GeKoppe/TouchPager/Documentation/TouchPager_Dokumentation_Thilo_Gerrit.pdf

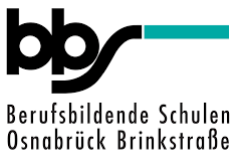
[picture p24: figure]

# Dokumentation Arduino Pager

## Autoren: Thilo Drehlmann, Gerrit Koppe

## Ausbildungsberuf: Fachinformatiker fur Anwendungsentwicklung ¨

## Klasse: IFA12

## Lernfeld 7: Cyberphysische Systeme ergänzen

## 7. Juni 2023

## Inhaltsverzeichnis

1 Ausgangssituation / Formulierung des Themas | 1
2 Ressourcen und Ablaufplanung | 1
3 Durchfuhrung ¨ | 3
4 Projektergebnis | 6
5 Anlagen | 8
5.4 Quellcode Auszuge | ¨ | 22
6 Glossar | 30
7 Quellenverzeichnis | 31

Dokumentation Arduino Pager | Lernfeld 7: Cyberphysische Systeme ergänzen | Thilo Drehlmann, Gerrit Koppe

## 1 Ausgangssituation / Formulierung des Themas

### 1.1 Beschreibung des Projektes

Das Thema des Projektes ist es, eine bidirektionale Kommunikation zwischen zwei Geräten auf Arduino-Basis zu gewährleisten. Es soll die Möglichkeit bestehen, Nachrichten zu verfassen, zu versenden und ebenso Nachrichten zu empfangen, die von einem anderen Arduino Gerät versendet wurden.

### 1.2 Definition der Ziele, erwartetes Ergebnis

1. Es soll möglich sein, mittels eines Touchscreens und einer virtuellen Tastatur, Zeichenketten auf einem, an den Arduino angeschlossenen Touchscreen, zu schreiben.
2. Die eingegebenen Zeichenketten sollen, mittels Funkwellen, an ein anderes Gerät ubertragen werden ¨ können.
3. Das Gerät soll in der Lage sein, Funkwellen zu empfangen.
4. Das Gerät soll außerdem in der Lage sein, die empfangenen Funkwellen wieder zu einer Zeichenkette zu ubersetzen und auf einem Touchscreen anzuzeigen. ¨
5. Es soll ein graphisches User Interface auf dem Touchscreen geben.
6. Es soll möglich sein, empfangene Nachrichten zwischenzuspeichern, damit neu empfangene Nachrichten nicht die vorherigen Nachrichten uberschreiben. ¨
7. Es soll möglich sein, den Zwischenspeicher der Nachrichten uber einen eigenen Men ¨ | upunkt abzurufen ¨
und die empfangenen Nachrichten zu verwalten.
Außerdem gibt es folgende, optionale Ziele:
a. Das User Interface soll anpassbar sein (Farben, Tastaturlayout).
b. Es soll möglich sein, zu uberpr ¨ | ufen, ob empfangsbereite Ger ¨ | äte in der Nähe sind.
c. Es soll möglich sein, die Antenne zu konfigurieren (Distanz und Frequenz).

## 2 Ressourcen und Ablaufplanung

### 2.1 Allgemeine und Ressourcenplanung

Zunächst ist fur die Planung relevant, welche Hardware Komponenten sowohl f ¨ | ur das Versenden von ¨
Nachrichten, als auch fur die menschliche Schnittstelle verwendet werden sollen. ¨
Fur die drahtlose Kommunikation kann auf verschiedene Technologien wie Bluetooth oder Radio-Frequenz ¨
zuruckgegriffen werden. Da Bluetooth nur eine sehr eingeschr ¨ | | | änkte Reichweite besitzt und eine Kopplung
der Geräte notwendig ist, wurde sich dafur entschieden, die drahtlose ¨ | Ubertragung per Radiofrequenz ¨
durchzufuhren. Außerdem existieren f ¨ | ur eine solche ¨ | Ubertragung kosteng ¨ | unstige Hardware und fertige ¨
API-Bibliotheken fur diese. Aus diesen Gr ¨ | unden wurde sich f ¨ | ur die nRF24L01+ Transceiver (im Folgen- ¨

den als ”

Antenne“ oder ”

Transceiver“ bezeichnet) entschieden.¹

Fur die Umsetzung der menschlichen Schnittstelle sollten zun ¨ | | | ächst ein Numpad, sowie ein 16x2 Li-
quid Crystal Display verwendet werden. Aufgrund der stark eingeschränkten Nutzbarkeit des LCD, sowie umständlicher Eingabe uber das Numpad, wurde sich stattdessen entschieden, einen Touchscreen zu ¨ verwenden. Da bereits Arduino Uno R3 Boards der Marke Elegoo zur Verfugung standen, wurde sich ¨ hier fur den Elegoo TFT 2,8” Touchscreen (im Folgenden als ¨
”
| | | TFT“ oder ”

Touchschreen“ bezeichnet)

1Vgl. Hardware Link 1 entschieden.² Dieser hat außerdem den Vorteil, dass Elegoo Bibliotheken mitliefert, um den Touchscreen

zu programmieren.
Schlussendlich musste noch entschieden werden, welches Arduino Board verwendet werden sollte. Aufgrund guter Erfahrung mit der Marke Elegoo in Hinsicht auf Zuverlässigkeit und Nutzbarkeit, wurde sich fur ebenjene Marke entschieden. Da der Touchscreen als Shield ¨

3
fur Arduino Uno Boards konzipiert ¨ ist, wäre es bei einem Arduino Uno nicht mehr möglich, weitere Hardware Komponenten anzuschließen. Entsprechend fiel die Entscheidung auf den Elegoo Arduino Mega R3⁴
, da dieser deutlich mehr Pinouts
zur Verfugung stellt, als ein Arduino Uno. Weitere Gr ¨ | unde f ¨ | ur diese Entscheidung sind, dass der Tran- ¨
sceiver uber den SPI Bus des Arduinos kommuniziert, dieser w ¨ | äre bei einem Arduino Uno aber durch
den TFT blockiert. Außerdem wird viel Quellcode erwartet, was bedeutet, dass der Programmierspeicher

des Arduino Uno zu klein sein könnte, auch hier hat der Arduino Mega mehr Ressourcen.

### 2.2 Ressourcen

### 2.2.1 Benötigte Hardware

In Anhang Tabelle 1 findet sich eine detaillierte, tabellarische Auflistung aller in Kapitel 2.1 genannten Komponenten, ihrer Aufgaben und ihrer Preise. Alle Komponenten werden zwei mal benötigt, da eine Kommunikation zwischen zwei identischen Geräten hergestellt werden soll.

### 2.2.2 Benötigte Software

Zur Umsetzung des Projekts wird, um die Programmierung zu vereinfachen und den Quellcode schlanker zu halten, auf verschiedene externe Bibliotheken zuruckgegriffen. Eine detaillierte Auflistung dieser ¨ Bibliotheken findet sich im Anhang Tabelle 2.

### 2.2.3 Zeitliche Planung der Umsetzung

Ein Netzplan mit detaillierter Zeitplanung findet sich im Kapitel 5.2 Abbildung 2. Der Plan lässt sich weiterhin unterteilen in die Planungsphase (Schritte 1-6) und die Umsetzungsphase (alle weiteren Schritte), abgebildet in Kapitel 5.2 Abbildung 3 und Abbildung 4.

Da vor der Umsetzung des Projekts keine Erfahrung im Umgang mit der Arduino Plattform bestand, wurden bei der Planung der gesamten Planungsphase (Netzplan Schritte 1-6) viel Zeit eingeräumt, durch

die fehlendes Wissen und Einarbeitung kompensiert werden sollten. Des Weiteren wurden 6, beziehungsweise 8 Stunden geplant, damit die Umsetzenden sich mit den einzelnen Komponenten vertraut machen konnten (Netzplan Schritte 4 und 5). Nach erfolgreicher Einarbeitung wurden weitere 2 Stunden fur die ¨ Konzeptionierung des Quellcodes eingeplant⁵
. Die zeitliche Planung der Umsetzung wurde erst nach der
Planungsphase durchgefuhrt, da diese abh ¨ | ängig vom, in der Planung entstandenen, Design des Quellco-
des war.⁶

Aufgrund des entstandenen Quellcode Designs konnte die Entwicklung der einzelnen Klassen parallel ablaufen und nur die Klasse ”

Messenger“ war davon abhängig, dass die anderen Klassen bereits fertig gestellt waren. Entsprechend wurde die Entwicklung der Klassen ”

VKeys“, ”

Radio“ und ”

ColorChooser“
zeitgleich eingeplant, wobei der Radio-Klasse die längste Dauer der Entwicklung eingeplant wurde. Jeder

2Vgl. Hardware Link 3
3Vgl. Glossar 6.2: Shield
4Vgl. Hardware Link 2
5Ergebnis abgebildet in Kapitel 5.2 Abbildung 6.
6Alle bis hier beschriebenen Schritte sind in Kapitel 5.2 Abbildung 3 abgebildet

Klasse wurde außerdem eine Testphase, entsprechend ihrer erwarteten Komplexität, eingeplant.
Im Anschluss wurde die Messenger-Klasse mit dem größten zeitlichen Aufwand von 14 Stunden Entwicklung und 5 Stunden Testen eingeplant, da diese die Kommunikation aller Komponenten sicherstellen soll. Abschließend wurde noch Zeit fur Tests des fertigen Systems und abschließendes Debuggen, sowie das ¨ Schreiben dieser Dokumentation, eingeplant.⁷

### 2.2.4 Erwartete Schwierigkeiten

Im Folgenden werden alle Schwierigkeiten aufgelistet und erklärt, die während der Umsetzung des Pro-

jekts erwartet werden.
1. Distanzregulierung: Die Transceiver können in verschiedenen Signalstärken senden, die programma-
tisch eingestellt werden mussen. Wird eine zu hohe Signalst ¨ | ärke konfiguriert, leidet darunter allerdings
die Ubertragungsqualit ¨ | ät bei niedrigen Distanzen. Hier muss ein gutes Mittelmaß gefunden werden.
2. Wechsel zwischen Empfang und Senden: Da die Nachrichten bidirektional versendet werden sollen, die Transceiver aber nur halbduplex arbeiten, muss ein rechtzeitiger Wechsel der Antenne zwischen Senden und Empfang garantiert werden. Sollten beide Geräte gleichzeitig Senden, werden beide Nachrichten

verloren gehen.
3. Kein Multithreading: Da Arduinos nicht Multithreading-fähig⁸
sind, wird eine Schwierigkeit darin bestehen, permanent gleichzeitig die Nutzung des Geräts und den Empfang eingehender Nachrichten zu gewährleisten.

### 2.2.5 Arbeitsaufteilung

Die genaue Aufteilung der Aufgaben ist dem Netzplan in Abbildung 2 zu entnehmen.
Die Projektschritte wurden allgemein alle gemeinsam unternommen, da die Hardware doppelt aufgebaut werden musste und der Quellcode in einem Git Repository verwaltet wurde, wodurch die Umsetzenden

parallel an den gleichen Klassen arbeiten konnten. Um Zeit zu sparen, wurde nur bei Arbeitsschritten, die parallel ablaufen konnten (z.B. Schritte 7-12) die Arbeit getrennt voneinander durchgefuhrt. ¨

## 3 Durchfuhrung ¨

### 3.1 Schaltplan und Bau des Projekts

Zunächst wurde die Hardware zusammengebaut. Da der Touchscreen als Shield entworfen ist, konnte dieser einfach auf den Arduino Mega gesteckt werden.
Die Transceiver benötigten wiederum eine 5V Stromversorgung, sowie den SPI-Bus⁹ des Arduinos. Der SPI-Bus des Arduino Mega 2560 R3 besteht aus den Pins D50-D53¹⁰, welche nicht durch den

Touchscreen-Shield verwendet werden, weshalb hier keine Probleme entstehen. Fur die 5V Stromversor- ¨

gung wird einer der beiden 5V-Pins in der Pin-Reihe D22-D53 verwendet, da diese noch nicht durch den Touchscreen-Shield verwendet werden.
Somit kann das Projekt ohne Benutzung weiterer Komponenten gebaut werden. Ein Bild des aufgebauten Projekts befindet sich in Kapitel 5.3, Abbildung 14.
Der Schaltplan des Projekts ist in Abbildung 5 dargestellt.

7Alle bis hier beschriebenen Schritte sind in Kapitel 5.2 Abbildung 4 abgebildet

8
vgl. Glossar 6.1: Multithreading
9Vgl. Glossar 6.1: SPI
10Vgl. Abbildung 11

### 3.2 Konzeptionierung der Quellcode-Architektur

Zunächst wurden die Funktionalitäten definiert, die das Projekt bieten muss. Diese wurden anschließend thematisch aufgeteilt und einzelnen Klassen zugeordnet. Die benötigten Funktionalitäten wurden direkt aus den Zielen in Kapitel 1.2 abgeleitet. Die entsprechenden Ziele werden im Folgenden durch Fußnoten referenziert. Ziele können durch mehrere Klassen realisiert werden und können eventuell mehrfach aufgefuhrt werden. ¨
So wurden alle Funktionalitäten, welche mit dem Versenden und Empfangen von Nachrichten zu tun

haben, in einer Klasse gekapselt, welche ”

Radio“ genannt wurde. Diese Klasse sollte sowohl fur das Ver- ¨
senden und Empfangen von, durch den User eingegebenen, Nachrichten, als auch fur die ¨ | Uberpr ¨ | ufung ¨

auf Geräte in der Nähe und die Implementierung der RF24 API verantwortlich sein.¹¹

Eine weitere Aufgabe sollte die Implementierung einer Möglichkeit zur Eingabe von Nachrichten sein. Hier wurde sich dafur entschieden, eine virtuelle Tastatur auf dem Touchscreen anzuzeigen. Die Anzeige ¨ dieser Tastatur, sowie das Erkennen das eingegebenen Buchstaben, sollten in der Klasse ”

VKeys“ gekapselt werden.¹²

Des weiteren sollte eine eigene Klasse zur Auswahl von Farben erstellt werden, welche immer dann in-
stanziiert werden sollte, wenn der User einen Menupunkt ausw ¨ | ählt, mit dem das Aussehen des User
Interface verändert werden kann. Diese Klasse wurde ”

ColorChooser“ bennant und sollte alle möglichen Farben anzeigen und erkennen, welche Farbe ausgewählt wurde.¹³

Letztendlich musste noch eine Klasse konzeptioniert werden, die fur das User Interface verantwortlich ¨ sein sollte. Außerdem wurde sich entschieden, diese Klasse zu verwenden, um alle anderen Klassen zu implementieren und die gesamte Logik zentral zu steuern. Diese Klasse wurde ”

Messenger“ benannt.
Diese Klasse sollte außerdem fur die Men ¨ | uf ¨ uhrung und das Zwischenspeichern von Nachrichten verwen- ¨
det werden.¹⁴

Aus der Konzeptionierung ergab sich dann ein Klassendiagramm, welches in vereinfachter Version in Abbildung 6 dargestellt ist.

### 3.3 Umsetzung des Quellcodes

Da die konzeptionierte Architektur vorsah, eine Hauptklasse zu entwerfen, die wiederum 3 weitere Klassen verwendet, wurde sich entschieden, bei der Entwicklung des Quellcodes den Bottom-Up Ansatz¹⁵ zu

verwenden und zunächst die 3 verwendeten Klassen (”
VKeys“, ”

ColorChooser“ und ”

Radio“) zu entwi-

ckeln. Wie im Netzplan zu erkennen, wurden diese parallel entwickelt. Sowohl bei der Entwicklung von ”
ColorChooser“, als auch bei der von ”

VKeys“ ist aufgefallen, dass Touchscreen und Display, obwohl es die selbe physische Komponente ist, programmatisch zwei verschiedene Koordinatensysteme haben. Somit musste zunächst durch Ausprobieren herausgefunden werden, dass das Display (x,y)-Koordinaten im Bereich ([0,240],[0,320]) und der Touchscreen (x,y)-Koordinaten im Bereich ([120,940],[70,920]) besitzt. Noch dazu ist die Y-Achse der beiden Komponenten zueinander invertiert (Display-Y: 0, Touchscreen-Y: 920 und Display-Y: 320, Touchscreen-Y: 70). Dieser Sachver-

halt ist in Kapitel 5.2, Abbildung 12 graphisch dargestellt. Um diese Diskrepanz zu uberbr ¨ ucken, musste ¨ eine Methode zum Ubersetzen der Koordinaten von Touchscreen zu Display geschrieben werden, um ¨

11Vgl. Kapitel 1.2, Ziele: 2,3,4,b,c
12Vgl. Kapitel 1.2, Ziele: 1,a 13Vgl. Kapitel 1.2, Ziel: a
14Vgl. Kapitel 1.2, Ziele: 2,5,6,7,c 15Vgl. Glossar 6.1: Bottom-Up

Usereingaben trotzdem korrekt zu verarbeiten.¹⁶

Abgesehen von der genannten Schwierigkeit, konnten beide Klassen aber im geplanten Zeitrahmen entwi-

ckelt werden. Im Weiteren wird hier aber hauptsächlich die VKeys Klasse beschrieben, da ”

ColorChooser“
haupsächlich entwickelt wurde, um sich in einer kleinen Klasse mit dem TouchScreen vertraut zu machen. Genutzt wurde bei der Entwicklung von ”

VKeys“ hauptsächlich die von Elegoo mitgelieferte Schnittstelle

zum Display, die in den Bibliotheken ”

TouchScreen“ und ”
Elegoo TFTLCD“ gekapselt wurdeFur beide ¨ Klassen wurde jeweils eine Methode geschrieben, um die TouchScreen-Beruhrung zu interpretieren und, ¨

anhand der eingegebenen Koordinaten, den Wert der gewählten Taste zuruckzugeben ¨

17. Des Weite-

ren wurde fur beide Klassen eine Methode geschrieben, die ihr jeweiliges Interface auf den Bildschirm ¨ druckt.¹⁸
Ebenfalls parallel wurde die Klasse ”
Radio“ entwickelt, die alle Funktionalitäten zur Kommunikation der beiden Geräte beinhalten sollte. Um die Transceiver ansteuern zu können, wurde die RF24 Treiber Bibliothek von TMRh20 verwendet¹⁹. Hier wurden zunächst die Methoden zum Senden²⁰ und zum Empfangen²¹ der Nachrichten entwickelt. Beim Empfangen der Nachrichten musste darauf geachtet werden,

dass diese Methode später auch genutzt werden sollte, um Kommandos zu empfangen, wie zum Beispiel
die Anfrage auf Verfugbarkeit, welche wiederum nicht die empfangene Nachricht zur ¨ | uckgeben sollte, ¨
sondern die Verfugbarkeit zur ¨ | uckmelden. ¨
Eine weitere Schwierigkeit bestand in der Typisierung der zu ubertragenden Nachrichten. Es wurde, der ¨ Ubersichtlichkeit und Einfachheit halber, die meiste Zeit mit dem Datentyp String gearbeitet, um Zei- ¨

chenketten zwischen Methoden zu ubergeben. Da dieser Datentyp aber keine Informationen beinhaltet, ¨ sondern nur einen Pointer zu einem char-Array, kann ein String nicht ubertragen werden. Um dieses ¨ Problem zu umgehen, musste der String vor der Ubertragung zu einem char-Array konvertiert werden ¨

und nach dem Empfangen wieder zuruck zu einem String. Hierf ¨ | ur wurden in der Radio-Klasse Metho- ¨
den geschrieben, die automatisch aufgerufen werden, sobald eine Nachricht versendet oder empfangen wird²²
Um die erwartete Schwierigkeit 2 in Kapitel 2.2.4 präventiv zu unterbinden, wurde sich entschieden, die Klasse so zu bauen, dass beim Verlassen jeder Methode die Antenne wieder auf lauschen gestellt wird und das Senden nur kurzzeitig aktiviert wird, sollte eine Nachricht ubertragen werden. ¨
Schlussendlich wurde fur die ¨
”
Radio“ Klasse noch die Methode geschrieben, um auf verfugbare Ger ¨ | äte
zu uberpr ¨ | ufen. Diese sollte eine vordefinierte Kommandosequenz senden und anschließend abwarten, ob ¨
eine weitere vordefinierte Kommandosequenz zuruckgesendet wird ¨

23
Alle bis zu diesem Punkt entwickelten Klassen wurden einzeln getestet. Zuletzt wurde die Klasse ”

Messenger“ entwickelt, die alle Funktionalitäten des Projekts kapseln und die bisher entwickelten Klassen implementieren sollte²⁴
Zunächst wurden der allgemeine Aufbau des User Interface, sowie die Logik der Menuf ¨ uhrung definiert. ¨ Es wurde entschieden, dass jedes Menu gleich aufgebaut sein soll, um einfachere Verwaltung des Codes ¨ zu gewährleisten²⁵. Damit es immer möglich ist, Nachrichten zu empfangen, musste in jedem Menu der ¨

16Vgl. Kapitel 5.4.1, Codeausschnitt ”
Konvertierung Touchscreen zu Screen Koordinaten“ 17Vgl. Kapitel 5.4.3, Codeausschnitt ”
Erkennung Tastatur Knopf“
18Vgl. Abbildung 18
19Kapitel 7.3, Link 1
20Konzept der Methode in Abbildung 9, Quellcode in Kapitel 5.4.2, Codeausschnitt ” Empfangen von Nachrichten“ 21Konzept der Methode in Abbildung 8, Quellcode in Kapitel 5.4.2, Codeausschnitt ” Senden von Nachrichten“
22Vgl. Kapitel 5.4.2, Codeausschnitt ”
Konvertierung String zu Char-Array“ 23Vgl. Abbildung 10, Quellcode in Kapitel 5.4.2, Codeausschnitt ”
Uberpr ¨ | ufung auf verf ¨ | ugbare Ger ¨ | äte“
24Vgl. Abbildung 6
25Vgl. Abbildung 7, Beispielcode eines Menus in Kapitel 5.4.1, Codeausschnitt ¨ ”
Beispiel Menuf ¨ uhrung: Optionenmen ¨ | u“¨

Klasse regelmäßig auf eingehende Nachrichten uberpr ¨ uft werden und, sollte eine Nachricht empfangen ¨ werden, diese Nachricht, entsprechend des Ziels 6 aus Kapitel 1.2, in einen Nachrichtenspeicher geschrieben werden. Da der Arduino nicht Multithreadfähig ist²⁶, konnte der Prozess nicht parallel laufen,

weswegen die Funktion in jedem einzelnen Menu eingebaut werden musste. ¨
Es wurde ein Hauptmenu entwickelt, aus dem heraus ausgew ¨ | ählt werden kann, ob eine Nachricht geschrie-
ben, empfangene Nachrichten im Zwischenspeicher gelesen, das Gerät konfiguriert oder auf Verfugbarkeit ¨ anderer Geräte getestet werden soll²⁷. Wird ”
Schreiben“ ausgewählt, wird eine Methode aufgerufen, die

”

VKeys“ Klasse initialisiert, wodurch es ermöglicht wird, eine Nachricht zu verfassen. Unter ”

Optionen“
wurden alle Möglichkeiten der Konfiguration, wie zum Beispiel Anpassung der Farben des Interface durch Instanziierung der ”

ColorChooser“-Klasse, aber auch die Konfiguration der Distanz durch Einstellen des

”

Radio“-Objekts. Des Weiteren wurde ein Menupunkt eingef ¨ | ugt, mit welchem manuell auf verf ¨ | ugbare ¨
Geräte in der Nähe gepruft werden kann, welcher wiederum bei Auswahl die entsprechende Methode des ¨

”

Radio“-Objekts aufruft²⁸
Der Zwischenspeicher wurde uber einen privaten String-Array realisiert, in den jede empfangene Nach- ¨ richt geschrieben wird. Hier wurde sich entschieden, dem Speicher nur eine Größe von 3 Nachrichten zu geben, um den Speicherplatz des Arduinos zu schonen. Wird eine Nachricht empfangen und der
Array ist bereits gefullt, so wird die ¨ | älteste Nachricht gelöscht, um Platz fur die neue Nachricht zu ma- ¨
chen²⁹. Dieser Zwischenspeicher kann im Hauptmenu unter ¨
”

Lesen“ ausgelesen werden und es besteht die Möglichkeit, alte Nachrichten manuell zu löschen.
Nachdem die ”

Messenger“-Klasse entwickelt war und alle weiteren Klassen in diese implementiert wurden, wurde das gesamte Projekt noch abschließend getestet und jeglicher Fehler behoben, der bei der Implementierung aufgetreten war.

## 4 Projektergebnis

### 4.1 Qualitätskontrolle

Ein wichtiges Qualitätsmerkmal des Projekts ist die korrekte und zuverlässige Ubertragung eingegebener ¨

Nachrichten. Um dies zu testen, wurden mit jeder der konfigurierbaren Einstellungen der Signalstärke der RF24-API (Min, Low, High und Max) 5 mal die gleiche Nachricht in verschiedenen Distanzen gesen-

det und gezählt, wie viele der Nachrichten korrekt ubertragen wurden ¨

30. Hier muss allerdings erwähnt
werden, dass die Ubertragung in einem Geb ¨ | äude mit groß ausgebautem WLAN Netz getestet wurde,

dementsprechend also sowohl Wände, als auch WLAN-Interferenzen das Testergebnis beeinträchtigt haben könnten. Des Weiteren waren die Stichprobe und die Dsitanzen relativ klein.
Es ist aber zu erkennen, dass jede der Signalstärkeneinstellungen in mindestens einer der getesteten
Distanzen jede Nachricht korrekt ubertragen hat, die Qualit ¨ | ät der Ubertragung also gut ist. ¨

Leider werden, da die Transceiver innerhalb des 2.4GHz Bands arbeiten, auch teilweise Interferenzen als Nachrichten erkannt, was durch die Umsetzung nicht abgefangen wurde.
Des Weiteren sind die Arduinos aktuell noch auf ein Netzteil angewiesen, da ansonsten die Ubertragung ¨

fehlschlägt, da die 5V Pins des Arduino Mega die Transceiver nicht korrekt zu versorgen scheinen, was durch die Umsetzenden nicht behoben werden konnte. Auch eine angeschlossene Batterie hat leider keine

26Vgl. Kapitel 2.2.4, Punkt 3
27Vgl. Abbildung 15
28Vgl. Abbildung 10, Quellcode in Kapitel 5.4.2, Codeausschnitt ”
Uberpr ¨ | ufung auf verf ¨ | ugbare Ger ¨ | äte“
29Vgl. Kapitel 5.4.1, Codeausschnitt ”
Nachrichten zwischenspeichern“ 30Vgl. Abbildung 13

Abhilfe geschaffen. Sind die Netzteile nicht angeschlossen, ist die Ubertragung gar nicht m ¨ | öglich oder

der Transceiver gibt unregelmäßig Signale an den Arduino weiter, welche wiederum als unleserliche Zei-

chenketten interpretiert werden. Dieses Verhalten wird auch durch einen Wackelkontakt des Kabels am 5V Pinout ausgelöst, was wiederum durch Löten der Komponenten behoben werden könnte, allerdings nicht umgesetzt ist.

### 4.2 Soll-Ist-Vergleich

Im Folgenden wird uberpr ¨ uft, ob die in Kapitel 1.2 erreicht wurden. ¨ Ziel 1 wird durch die Klasse ”

VKeys“ abgebildet und in der Klasse “Messenger”

implementiert. Es ist
auch möglich, Sonderzeichen zu schreiben, das Ziel ist also erfullt ¨

31
Die Ziele 2, 3 und 4 werden durch die Klasse ”

Radio“ abgebildet und ebenfalls durch die Klasse ” Messen-
ger“ implementiert. Die Qualität der Ubertragung wurde getestet und das Ergebnis ist zufriedenstellend ¨ | 32
Dieses Ziel ist somit ebenfalls erreicht.
Ziel 5 wird durch die Klasse ”

Messenger“ abgebildet und implementiert. Das graphische User-Interface hat außerdem eine Menuf ¨ uhrung ¨

33. Entsprechend kann das Ziel als erreicht bewertet werden.

Ziel 6 wird ebenfalls durch die Klasse ”
Messenger“ abgebildet und implementiert. Es existiert ein Zwi-
schenspeicher fur insgesamt 3 Nachrichten, aus dem die ¨ | älteste Nachricht entfernt wird, sollte eine
weitere Nachricht empfangen werden. Dieses Ziel ist somit abgebildet
Ziel 7 wird auch durch die Klasse ”

Messenger“ abgebildet und implementiert. Es wurde im Hauptmenü
ein eigener Menupunkt zum Lesen der Nachrichten implementiert, der wiederum in ein eigenes Men ¨ | ü
fuhrt ¨

34, das Ziel ist also erfullt. ¨
Auch die optionalen Ziele wurden alle erfullt. Es ist m ¨ | öglich, das User Interface farblich anzupassen³⁵
,
es ist möglich, manuell zu prufen, ob empfangsbereite Ger ¨ | äte in der Nähe sind und es kann uber die ¨
Optionen die Sendedistanz eingestellt werden.
Zusammenfassend kann also gesagt werden, dass jedes Ziel erfullt wurde, die Ger ¨ | äte allerdings nicht mo-
bil sind, da noch keine Lösung fur das ben ¨ | ötigte Netzteil gefunden wurde, wodurch eine der Grundideen
des Projekts leider nicht realisiert wurde.

### 4.3 Ausblick

Es wurde noch keine Halterung / kein Case fur das Projekt gebaut, wodurch es aktuell noch nicht robust ¨

ist. Sollte das Projekt fortgesetzt werden, wäre dies der nächste Schritt.
Eine interessante Erweiterung fur das Projekt w ¨ | äre außerdem die Entwicklung eines eigenen Formats der
Nachrichten oder einem eigenen Protokoll der Ubertragung, um sicherzustellen, dass nur Nachrichten, die ¨

tatsächlich von Geräten mit der entwickelten Technologie, verarbeitet werden und somit Interferenzen ignoriert werden. So könnten außerdem, zu den Nachrichten gehörende, Metadaten (Uhrzeit, Geräte-
ID etc.) ubertragen werden, wodurch die Kommunikation deutlich pr ¨ | äziser wird und auch nur, sollten
mehrere Geräte gleichen Typs in der Umgebung verfugbar sein, ein bestimmtes Ger ¨ | ät angesprochen
werden. Ein solches Protokoll wurde auch das Senden von Kommandosequenzen vereinfachen. ¨

31Vgl. Abbildungen 18 und 19 32Vgl. Abbildung 13
33Vgl. Abbildung 15
34Vgl. Abbildung 20
35Vgl. Abbildung 17 und Abbildung 16

## 5 Anlagen

### 5.1 Auflistung der Komponenten

Tabelle 1: Benötigte Hardware

Hardware | Aufgabe | Kosten
Arduino Mega 2560 | - Zentrale Schnittstelle aller Komponenten - Programmierbarkeit, Verwaltung der Logik | 2 x 21,99¿
Elegoo Uno TFT Touchscreen 2,8” | - Anzeige von Nachrichten - Eingabe von Nachrichten - User Interface | 2 x 19,99¿
nRF24L01+ Wireless Transcei-ver Modul | - Nachrichten Ubertragen und Empfangen ¨ - Uberpr ¨ ufung Verf ¨ ugbarkeit anderer Ger ¨ äte | 2 x 5,-¿
Elegoo Power Supply 9V | - Stromzufuhr fur 5V Pin ¨ | 2 x 8,99¿

Gesamtkosten: 111.92¿.
Links zur genutzten Hardware sind in Kapitel 7.2 aufgefuhrt. ¨

Tabelle 2: Benötigte Software

Bibliothek | Aufgabe | Quelle
Elegoo GFX.h | Kern Grafikbibliothek des Elegoo Uno TFT Touchs-creens. Ermöglicht das Drucken von Zeichen / For-men auf TFT Display. | Mitgeliefert auf CD bei TFT Touchs-creen
Elegoo TFTLCD.h | Hardware-Bibliothek des Elegoo Uno TFT Touchs-creens. Verantwortlich fur die Kommunikation des ¨ Programms mit der Hardware. | Mitgeliefert auf CD bei TFT Touchs-creen
TouchScreen.h | Bibliothek des Touchscreens des Elegoo Uno TFT Touchscreens. Erlaubt das erkennen von Beruhrungen des Touchscreens und die Lokalisierung ¨ der Beruhrung. ¨ | Mitgeliefert auf CD bei TFT Touchs-creen
SPI.h | Erlaubt die Kommunikation des Programms mit dem SPI Bus des Arduino Board | In Arduino IDE in-kludiert
nRF24L01.h | Hardware Bibliothek der nRF24L01+ Transceiver. Erlaubt Kommunikation des Moduls mit dem Ardui-no Board | Github
RF24.h | Programmierbare Schnittstelle der nRF24L01+ Transceiver. | Github
Arduino.h | Liefert Kernfunktionen der Arduino Boards. | In Arduino IDE in-kludiert

Links zur genutzten Software sind in Kapitel 7.3 aufgefuhrt. ¨

### 5.2 Diagramme


Abbildung 1: Legende der Netzplan Knoten


Abbildung 2: Netzplan des Projekts

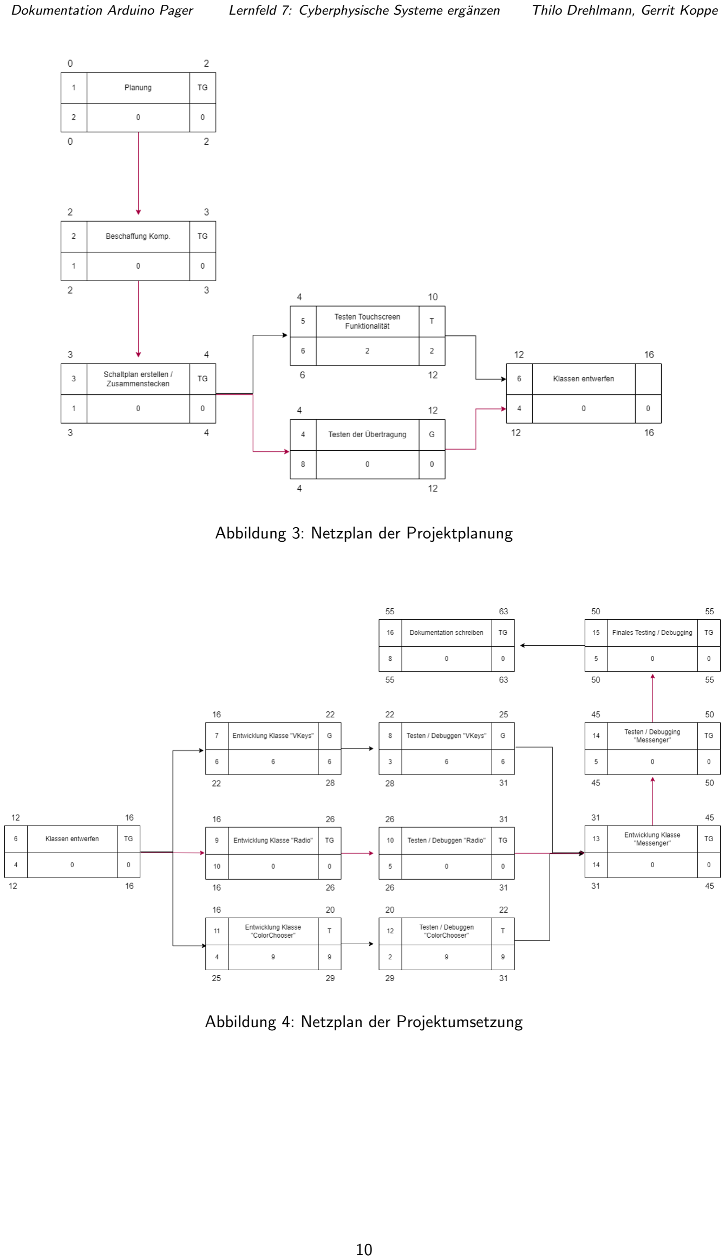
[picture p25: page 12]

Abbildung 3: Netzplan der Projektplanung

Abbildung 4: Netzplan der Projektumsetzung

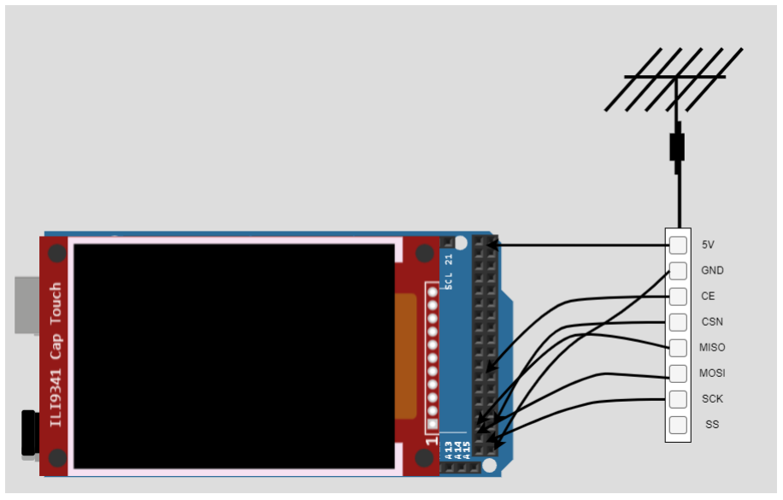
[picture p26: figure]

Abbildung 5: Schaltplan des Projekts

Da kein Tool gefunden wurde, das die im Projekt verwendeten Komponenten bereitstellt, wurde hier auf einen händisch erstellten Schaltplan zuruckgegriffen. Der Touchscreen wird als Shield verwendet und in den Arduino ¨ Mega gesteckt. Die Pin-Aufteilung der Transceiver lautet wie folgt:

Transceiver | Arduino
V++ | 5V
GND | GND
MISO | D50
MOSI | D51
SCK | D52
CE | D43
CSN | D53


Abbildung 6: Vereinfachtes Klassendiagramm des Arduino Programms


Abbildung 7: Aufbau der Menumethoden ¨


Abbildung 8: Ablauf des Nachrichtenempfangs


Abbildung 9: Ablauf des Sendens von Nachrichten


Abbildung 10: Ablauf des Testens auf verfugbare Ger ¨ | äte


Abbildung 11: Pinout Beschreibung des Arduino Mega 2560 R3, Quelle: Internetquelle 4

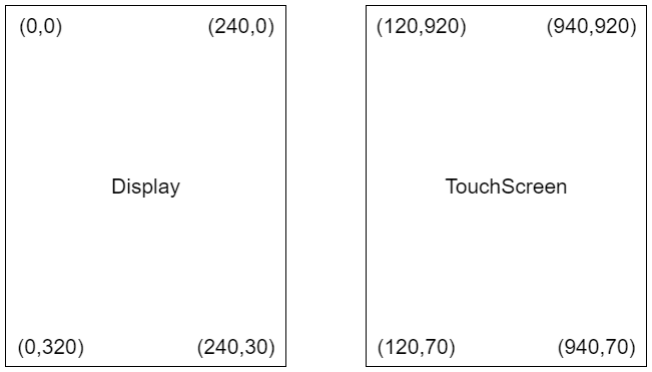
[picture p27: figure]

Abbildung 12: Darstellung der Koordinaten von Touchscreen und Display (x,y)

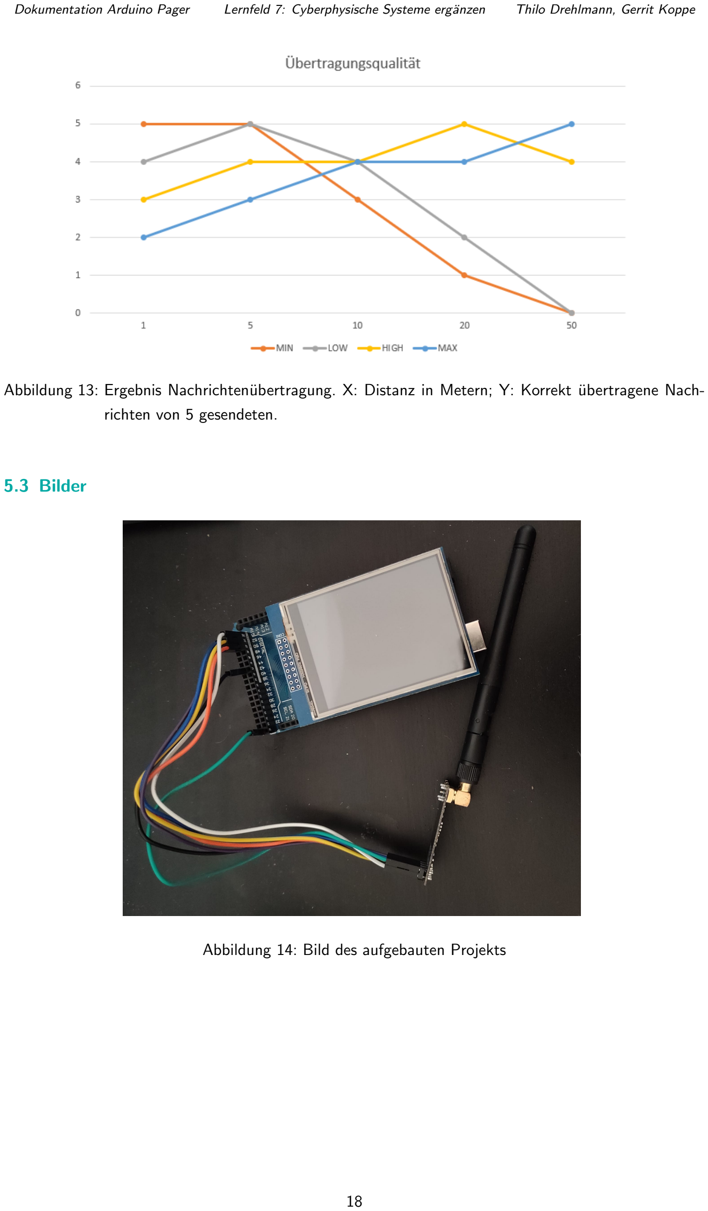
[picture p28: page 20]

Abbildung 13: Ergebnis Nachrichtenubertragung. X: Distanz in Metern; Y: Korrekt ¨ | ubertragene Nach- ¨
richten von 5 gesendeten.

### 5.3 Bilder

Abbildung 14: Bild des aufgebauten Projekts


Abbildung 15: Standard-Hauptmenu des Projekts ¨


Abbildung 16: Hauptmenu des Projekts mit Lightmode ¨


Abbildung 17: Farblich angepasstes Hauptmenü


Abbildung 18: Virtuelle Tastatur des Projekts


Abbildung 19: Virtuelle Tastatur des Projekts mit Sonderzeichen


Abbildung 20: Menu zum Lesen eingegangener Nachrichten ¨

### 5.4 Quellcode Auszuge ¨

Der gesamte Quellcode ist in einer Zip-Datei beigefugt. ¨
Im Folgenden sind in der Dokumentation benannte Funktionen und Methoden angefugt. ¨

### 5.4.1 Klasse: Messenger

Konvertierung Touchscreen zu Screen Koordinaten

/**

* @brief
* Parses Coordinates from touchpoint to screen coordinates *
* @param p TSPoint, Point the user touched on display
* @return ScreenParse Struct containing parsed screen coordinates */
ScreenParse Messenger::parseCoords(TSPoint p) {

ScreenParse parse;

// Touch X: [120,940], Screen X: [0,240] // Parse X
parse.x = (int) ((p.x - 120) / 3.5);

// Touch Y: [70,920], Screen Y: [0,320] // Parse Y
parse.y = (int) ((p.y - 70) / 2.66);

return parse;
}
Beispiel Menuf ¨ uhrung: Optionenmen ¨ | ü

/**

* @brief
* Options menu
*
*/
void Messenger::optsMenu(void) { pinMode(A2, OUTPUT);
pinMode(A3, OUTPUT);

Menu menu;
menu.menuStart = 60;
menu.menuThickness = 40;
menu.menuOffset = 20;
menu.header = "Optionen";
menu.entries[0] = String("Farben"); menu.entries[1] = String("Tastatur"); menu.entries[2] = String("Distanz"); menu.entries[3] = String("Zurueck"); menu.entries[4] = String("\0");

drawMenu(menu);

delay(100);

while (true) {
String inc = receiveMessage();
if (inc != "\0") Serial.println(inc);

int selection = -1;

// Get touchpoint
digitalWrite(13, HIGH);
TSPoint p = _ts->getPoint(); digitalWrite(13, LOW);

// If touch was recognized if (p.z > _minTouch) {
// Get selected menu poin
selection = getSelection(menu.menuStart, menu.menuThickness, menu.menuOffset, 4, parseCoords(p));

Serial.println("Selection: " + String(selection));

switch (selection) {

case -1: break;
case 1: colorMenu(); return; case 2: keysMenu(); return; case 3: distanceMenu(); return;

case 4: return;
default: break;
}
}
delay(10);
}

Serial.println("Returning from optsMenu"); }

Nachrichten zwischenspeichern

/**

* @brief
* Caches incoming messages in message cache *
* @param msg String to be cached
*/
void Messenger::cacheMessage(String msg) { // Check, how many messages are in cache

int counter = 0;
for (int i = 0; i < 3; i++) {
if (_messages[i] != "\0") {

counter++;
continue;

} else {

break;
}
}

// If message already is in cache, return for (int i = 0; i < counter; i++) {
if (msg == _messages[i]) return;
}

// If there are less than 3 messages, just cache the newest message on last position if (counter < 3) {
_messages[counter] = msg;

return;
} else {
// If there are 3 messages, clear the last message _messages[0] = "\0";

// Push every other message one to the back for (int i = 1; i < 3; i++) {
_messages[i - 1] = _messages[i];
}

// Put new Message as first in the array _messages[2] = msg;

return;
}
}

### 5.4.2 Klasse: Radio

Empfangen von Nachrichten

/**

* @brief
* Receives message from radio frequency
*
* @return String received message or \0, if nothing was gotten */
String Radio::receiveMessage(void) {
char buffer[128] = "";

String msg = "";

// Switch from sending to listening if (!_listening) switchState();

// If no message is available, return universal break character if (!_antenna.available()) {
//Serial.println("Receiving: No Antenna available"); return "\0";

}
Serial.println("Receiving: Antenna available");

// Read available payload
_antenna.read(&buffer, sizeof(buffer));

for (int i = 0; i < 128; i++) {
msg += String(buffer[i]);
if (buffer[i] == ’\0’) break; }

Serial.println("Receiving: Received char Array: " + msg);

// If the test string was received, acknowledge it and return \0 if (msg == String(_test)) {
Serial.println("Receiving: Test string, now acknowledging."); acknowledge();
return "\0";
}

// If acknowledge string was received, change marker in class fields to true so it can be checked by other methods and return \0
if (msg == String(_acknowledge)) {
Serial.println("Receiving: Acknowledge String");

_ackHappened = true;
return "\0";
}

return msg;
}

Senden von Nachrichten

/**

* @brief
* Sends message given in param *
* @param msg Message to be sent
* @return true If sending was successful * @return false otherwise
*/
bool Radio::sendMessage(String msg) {

String sendTest = "";
bool tx_ok, tx_fail, rx_ready, test = true; char buffer[128];
msg.toCharArray(buffer, msg.length() + 1);

Serial.println("Sending message: " + msg);
Serial.println("Listening State: " + String((_listening ? "listening" : "writing")));

if (_listening) switchState();

Serial.println("Listening State: " + String((_listening ? "listening" : "writing")));

// convertStringToCharArray(msg, buffer);
for (int i = 0; i < msg.length(); i++) { sendTest += String(buffer[i]);
}
Serial.println("Sending: Char Arr after conversion: " + sendTest);

test = _antenna.write(&buffer, sizeof(buffer));

if (!test) {
Serial.println("Sending unseccessful");
_antenna.whatHappened(tx_ok, tx_fail, rx_ready);
Serial.println("OK: " + String((tx_ok ? "Yes" : "No")) + ", FAIL: " + String((tx_fail ? "Yes" : "No")) + ", READY: " + String((rx_ready ? "Yes" : "No")));
switchState();

return false;
}

Serial.println("Returning from sending"); switchState();

return true;
}
Uberpr ¨ | ufung auf verf ¨ | ugbare Ger ¨ | äte

/**

* @brief
* Checks, whether there are devices available nearby *
* @return true If there are devices available nearby * @return false otherwise
*/
bool Radio::checkNearbyDevices(void) {

_ackHappened = false;
bool msg[5] = {false, false, false, false, false};

for (int i = 0; i < 5; i++) {
sendMessage(_test);
receiveMessage();

msg[i] = wasAcknowledged();
Serial.println("Msg " + String(i) + ": " + String((msg[i] ? "True" : "False"))); delay(1000);
}

// If payload was the acknowlege String, that means there are devices nearby.

for (int i = 0; i < 5; i++) { if (msg[i]) return true;
}

Serial.println("_ack: " + String((_ackHappened ? "True" : "False")));

_ackHappened = false;
return false;
}

Konvertierung String zu Char-Array

/**

* @brief
* Converts a given String s to a char array and saves it to given pointer a *
* @param s Strung to be converted to char array
* @param a Pointer to char array
*/
void Radio::convertStringToCharArray(String s, char a[128]) {

int counter = 0;

// Iterate through entire String and add character to char array for (int i = 0; i < s.length(); i++) {
a[i] = s.charAt(i);

counter++;
}

// Fill up char array with empty values for (int i = counter; i < 128; i++) { a[i] = ’\0’;
}

Serial.println("Char Arr after conversion: " + String(a)); }

Wechsel zwischen senden und lauschen

/**

* @brief
* Switches from listening to sending and the other way around *
*/
void Radio::switchState() { byte _adress[6] = "00001"; // Invert listening

_listening = !_listening;

// If listening: Prepare antenna for listening. Otherwise: Prepare antenna for sending

if (_listening) {
_antenna.openReadingPipe(_readingPipe, _adress); _antenna.startListening();
} else {
_antenna.stopListening();
_antenna.openWritingPipe(_adress); }

_antenna.setPALevel(_level); }

### 5.4.3 Klasse: VKeys

Erkennung Tastatur Knopf

/**

* @brief
* Returns selected char by calculating, which column and row was pressed from passed x and y coords
*
* @param x X coordinate from touchscreen selection
* @param y Y coordinate from touchscreen selection
* @return String Selected character parsed to a string, BACK if back button was selected and DONE, if done button was selected
*/
String VKeys::getCharFromCoords(int16_t x, int16_t y) {

int row, column;

// Complete Y: [70,920], range 850, keyboard [70,475], keyboard range of 405, 4 rows so 405/4 = 101.25
if (y > 475) return String(’\0’);
row = (int) ((y - 70)/ 101.25);

// row 0 is spacebar, therefore return escaped space immediately, as nothing else is

there.
if (row == 0) {
int tempX = (int)((x - 120) / 3.5);

if (tempX < (_screen->width() / 4)) {
return String("BACK");
} else if (tempX > 3*(_screen->width() / 4)) { return String("DONE");
}
return String(" ");
}

if (row > 3) return String(’2’);

// X Range ca. 120 - 920 for 10 columns, therefore 800 / 10 = 80 column = (int) ((x - 120)/ 80);

if (column < 11 && column >= 0 && row < 4 && row >0) return String(_special ? _specialChars[(3-row)][column] : _rows[(3-row)][column]);

return String(’-’);
}

### 5.4.4 Klasse: ColorChooser

Erkennen der ausgewählten Farbe

/**

* @brief
* Analyses coordinates passed into function and returns selected color *
* @param coords Coordinates of touchpoint, parsed to screen coordinates
* @return uint16_t chosen Color or 0, if cancelled or -2, if selection was not valid */
uint16_t ColorChooser::getSelection(Coords coords) {

int column, row;

Serial.println("CC: X: " + String(coords.x) + ", Y: " + String(coords.y));

// Check, if touchpoint is at height of cancel button
if (320 - coords.y > 250) return 0;

// If coordinates are out of valid ranges, return failure marker if (coords.x < 35 || coords.x > 215) return -2;
if (coords.x < 135 && coords.x > 100) return -2;

// If x is less than 100, it has to be first column (index 0), otherwise second column (index 1)

column = coords.x < 100 ? 0 : 1;

// Invert coordinates (320-y, because screen is 320 high) and divide by 60, because

that’s the
// height of the boxes, to get the row
row = (int)((320 - coords.y) / 60);

// Variable basically only exists, so that we don’t try to reach indices the array

does not have
// This works, because the first column has indices 0,2,4,6 and second has 1,3,5,7 int safeHandler = column + (row*2);

// If selection > 7, set selection to failure, otherwise set selection to selected

color
uint16_t selection = (safeHandler > 7 ? -2 : _colors[safeHandler]);

return selection;
}

## 6 Glossar

### 6.1 Technische Begriffe

Multithreading
Unter Multithreading versteht man in der Informatik den Prozess, ein Programm in mehrere Teilstränge aufzuteilen, die parallel ausgefuhrt werden. ¨

36

SPI-Bus
SPI steht fur Serial Peripheral Interface und ist ein, aus drei Leitungen bestehendes, Bussystem nach dem ¨ Master-Slave Prinzip, mit dem die Kommunikation verschiedener Komponenten gesteuert werden kann.³⁷

Bottom-Up
Der Bottom-Up Ansatz beschreibt in der Software-Entwicklung die Vorgehensweise, zunächst Teilfunktionen oder einzelne Klassen zu entwickeln und diese, nach ihrer Fertigstellung, zu einem System zu-
sammenzufuhren. Im Gegensatz hierzu wird bei der Top-Down Methode zun ¨ | ächst das System definiert,
ohne im Detail auf einzelne Funktionen einzugehen.³⁸

### 6.2 Arduino Begriffe

Shield
Ein Shield ist ein Schaltplatte, die die Funtkionalität eines Arduinos erweitern kann und meistens so

konzeptioniert ist, dass sie direkt in den Arduino gesteckt werden kann und diesen somit zum Teil oder vollständig abdeckt.³⁹

36Vgl. Internetquelle 1
37Vgl. Internetquelle 3
38Vgl. Internetquelle 5
39Vgl. Internetquelle 2

## 7 Quellenverzeichnis

### 7.1 Internetquellen

1. Storage Insider: Was ist Multithreading - Online unter https://www.storage-insider.de/

was-ist-multithreading-a-1017586/ (https://www.storage-insider.de/was-ist-multithreading-a-1017586/) [07.01.2023]

2. Computer Hope: Arduino Shield - Online unter https://www.computerhope.com/jargon/a/

arduino-shield.htm (https://www.computerhope.com/jargon/a/arduino-shield.htm) [07.01.2023]

3. Mikrocontroller.net: Serial Peripheral Interface - Online unter https://www.mikrocontroller.

net/articles/Serial_Peripheral_Interface (https://www.mikrocontroller.net/articles/Serial_Peripheral_Interface) [15.01.2023]

4. Electronics Hub: Arduino Mega Pinout - Online unter https://www.electronicshub.org/

wp-content/uploads/2021/01/Arduino-Mega-Pinout.jpg (https://www.electronicshub.org/wp-content/uploads/2021/01/Arduino-Mega-Pinout.jpg) [15.01.2023]

5. Geeks for Geeks: Difference between Bottom-Up Model and Top-Down Model - Online unter

https://www.geeksforgeeks.org/difference-between-bottom-up-model-and-top-down-model/[18.01.2023]

### 7.2 Links genutzter Hardware

1. nRF24L01+ Transceiver:

https://www.amazon.de/nRF24L01-Antenne-kabellos-Transceiver-Arduino/dp/B07TYVSSBZ/

2. Elegoo Arduino Mega R3:

https://www.amazon.de/Elegoo-Kompatibler-Mikrocontroller-Mega2560R3-ATmega2560/

dp/B071D4KP6B/ (https://www.amazon.de/Elegoo-Kompatibler-Mikrocontroller-Mega2560R3-ATmega2560/dp/B071D4KP6B/)

3. Elegoo TFT Touchscreen:

https://www.amazon.de/ELEGOO-Touchscreen-Arduino-Bibliotheken-Mitgeliefert/dp/

B01EUVJYME/ (https://www.amazon.de/ELEGOO-Touchscreen-Arduino-Bibliotheken-Mitgeliefert/dp/B01EUVJYME/)

### 7.3 Links genutzter Software

1. nRF24L01.h, RF24.h: Online unter https://github.com/nRF24/RF24
2. SPI.h, Arduino.h, Arduino IDE: Online unter https://www.arduino.cc/en/software

Die Bibliotheken Elegoo GFX.h, Elegoo TFTLCD.h und TouchScreen.h wurden auf einer CD beim Kauf des Elegoo TFT LCD mitgeliefert.
