GeKoppe/TouchPager/Documentation/Bilder/colorchooser.jpeg

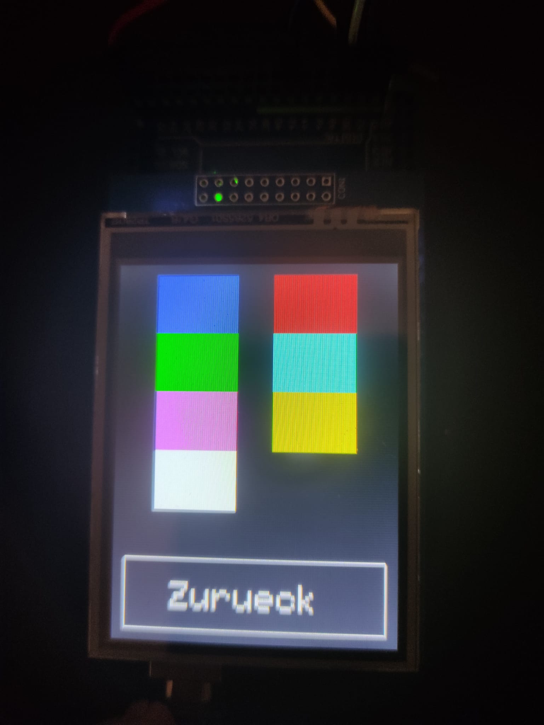
Documentation/Bilder/colorchooser.jpeg
