GeKoppe/TouchPager/Documentation/Bilder/Keys_ABCDE.jpeg

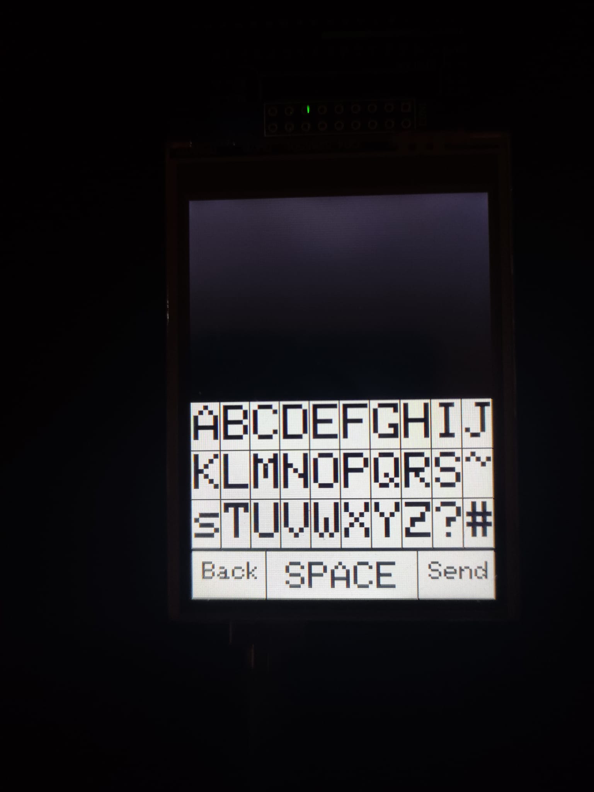
Documentation/Bilder/Keys_ABCDE.jpeg
