GeKoppe/TouchPager/Presentation/Bilder/Keys_ABCDE.jpeg

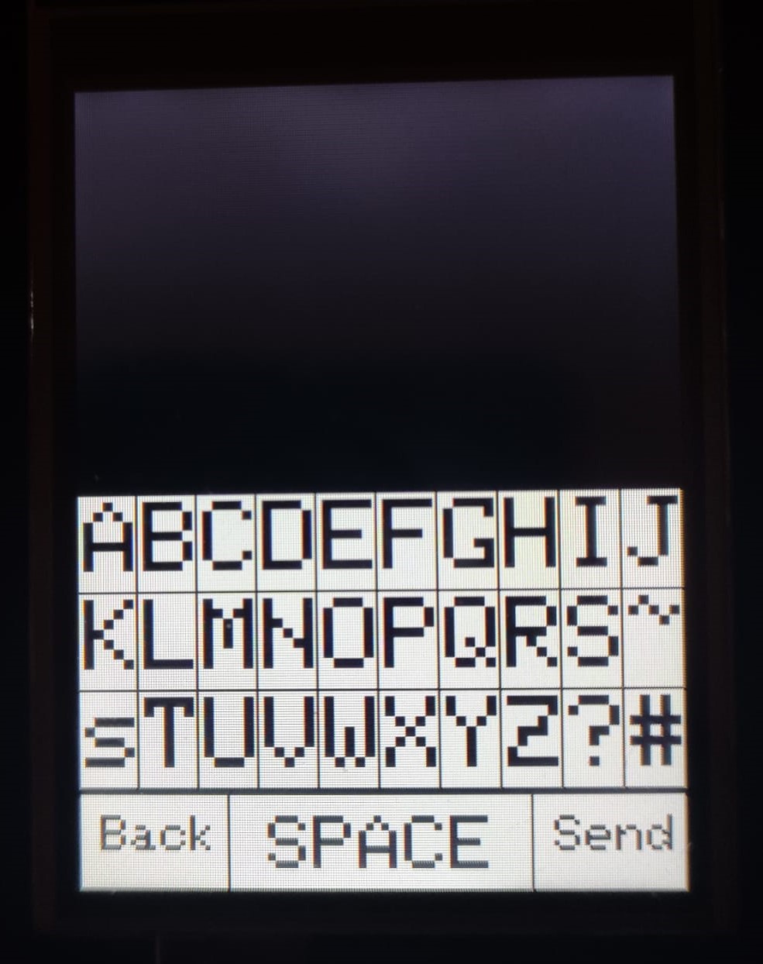
Presentation/Bilder/Keys_ABCDE.jpeg
