GeKoppe/TouchPager/Presentation/Bilder/MainMenu_Light.jpeg

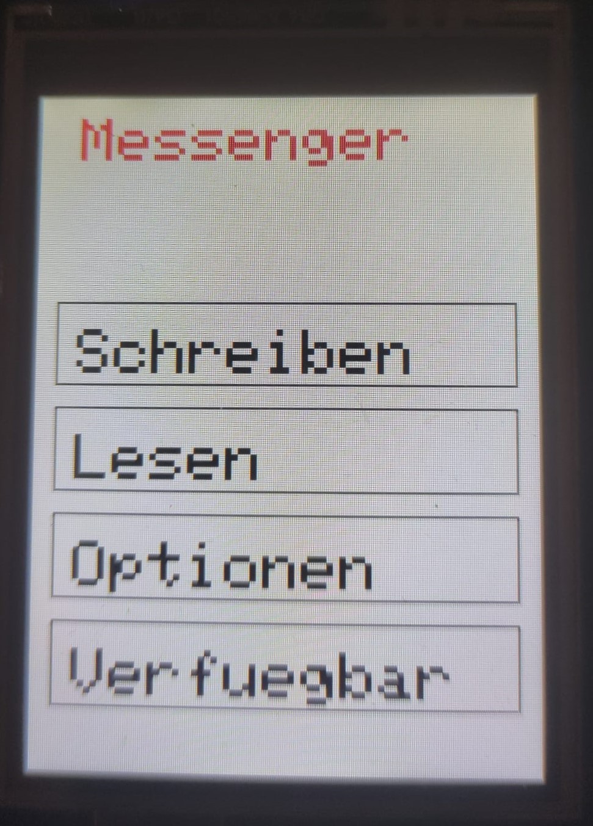
Presentation/Bilder/MainMenu_Light.jpeg
