GeKoppe/TouchPager/Presentation/Bilder/MainMenu_standard.jpeg

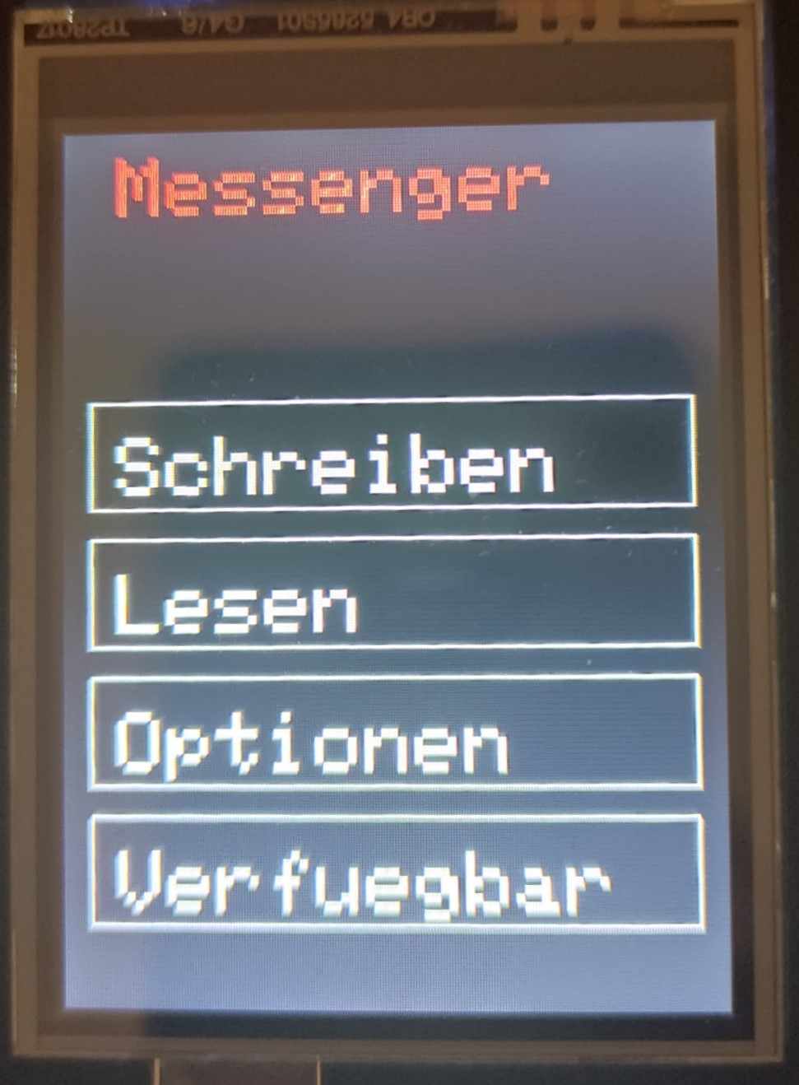
Presentation/Bilder/MainMenu_standard.jpeg
