GeKoppe/TouchPager/Presentation/Bilder/read_menu.jpeg

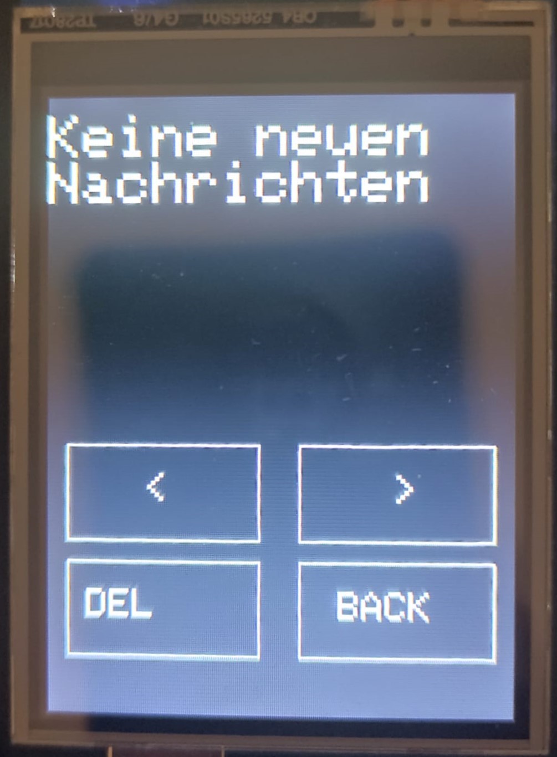
Presentation/Bilder/read_menu.jpeg
