GeKoppe/TouchPager/Radio.h

#ifndef radio_h
#define radio_h

#include <SPI.h>
#include <nRF24L01.h>
#include <RF24.h>
#include <Arduino.h>
#include <SoftwareSerial.h>

class Radio
{
public:
    Radio(uint16_t ce, uint16_t csn, SoftwareSerial *espLine);

    uint16_t getCE(void) { return _ce; };
    uint16_t getCSN(void) { return _csn; };

    uint8_t getPALevel(void)
    {
        Serial.println("PA Level: " + String(_antenna.getPALevel()));
        return _level;
    };
    void setPALevel(String level);

    int getReadingPipe(void) { return _readingPipe; };

    void setCE(uint16_t ce) { _ce = ce; };
    void setCSN(uint16_t csn) { _csn = csn; };
    void setListening(bool listen) { _listening = listen; };

    bool getListening(void) { return _listening; };

    bool getAck(void) { return _ackHappened; };

    void switchState(void);

    String receiveMessage(void);
    String receiveMessage(String type);
    String receiveMqttMessage(void);

    bool available(void);
    void init();

    bool sendMessage(String msg);
    bool sendMessage(String msg, String type);
    bool sendMqttMessage(String msg);
    bool checkNearbyDevices(void);
    bool checkNearbyMqtt();

private:
    SoftwareSerial *_espLine;
    int _serialTx = 23, _serialRx = 22, _serialBaud = 9600;
    uint16_t _ce, _csn, _readingPipe, _paLevel;

    uint8_t _level = RF24_PA_MIN;

    bool _listening = true;
    bool _ackHappened = false;

    String _jam = "1337";
    String _acknowledge = "4269";
    String _test = "42069";

    RF24 _antenna;
    void acknowledge(void);

    void convertStringToCharArray(String s, char a[256]);
    String convertCharArrayToString(char a[256]);

    bool wasAcknowledged();
};

#endif
