GeKoppe/TouchPager/(commit log)

2022-12-17 Fixed displaying s and displaying special chars
    [Messenger.cpp, VKeys.cpp]
2023-01-08 Added check for messages that are too long
    [Messenger.cpp]
2023-01-08 Fixed message switch, added information about message numbers to read menu
    [Messenger.cpp]
2023-01-11 Fixed some bugs, continued documentation
    [ColorChooser.h, Messenger.cpp]
2023-01-15 Modified check for nearby devices, made process for acknowledging better
2023-01-15 Changed variable names to prevent confusion
    [Radio.cpp, Radio.h]
2023-01-18 Trying to fix stuff
    [Messenger.cpp, Radio.cpp]
2023-01-18 Made nearbyCheck work, printed more stuff to display
2023-01-18 Brought it pack to a stage, where it works
2023-06-07 Fixed check for nearby devices
    [Radio.cpp, VKeys.h]
2023-06-07 Fixed checkfornearby for mqtt
    [Radio.cpp, Radio.h]
